ubldit/WIOT/Docs/WIOT_Rev2.jpg

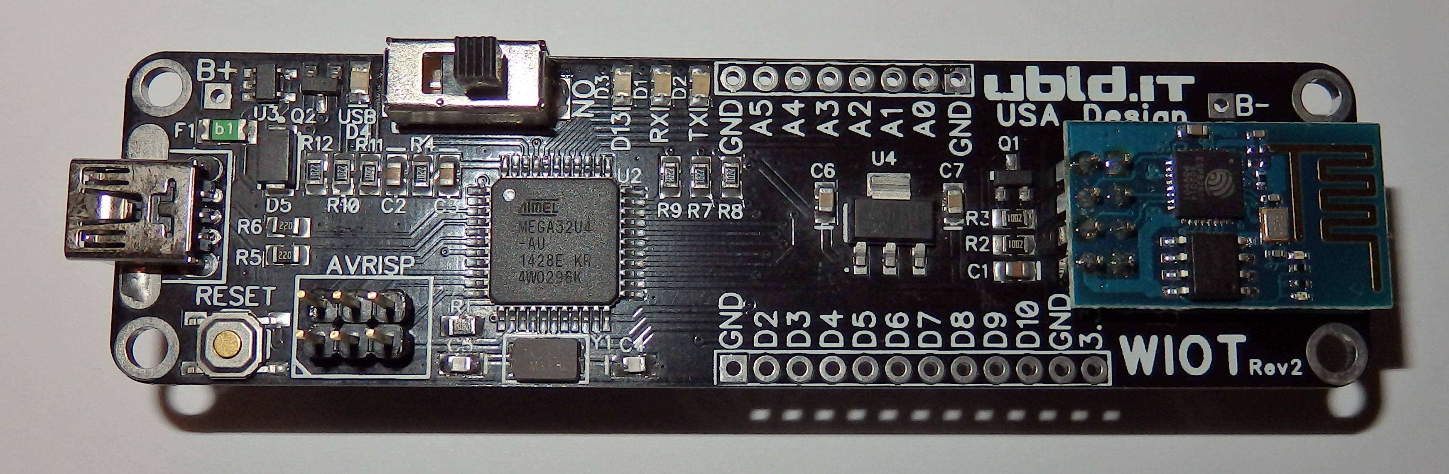
Docs/WIOT_Rev2.jpg
