ubldit/WIOT/README.md

# WIOT: Wireless Internet of Things Arduino-Compatible Board by ubld.it
Arduino Addon, firmware, example sketch, and schematics for the Wireless Internet of Things (WIOT) Arduino-Compatible WiFi (ESP-8266) Board by ubld.it

More information at:
<a href="http://WIOT.org">http://WIOT.org</a> and <a href="https://cockrum.net/electronics.html#WIOT_final">http://cockrum.net/electronics.html#WIOT_final</a>



Directories
-----------
Hardware/ -- Schematic, PCB Layers

Software/ -- Example Arduino sketches

Docs/ -- Documentation and Photos

Device Drivers/ -- Device drivers for WIOT board

License Information
-------------------
The hardware is released under [Creative Commons ShareAlike 4.0 International](https://creativecommons.org/licenses/by-sa/4.0/).

Distributed as-is; no warranty is given.
