ubldit/WIOT/Software/Arduino/README.txt

This directory contains the structure for using the board manager in Arduino 1.6.4
The package_ubld_index.json file must match this (SHA-256 hash and size)
