ubldit/WIOT/Hardware/ubld.it WIOT Rev2 Schematic.pdf

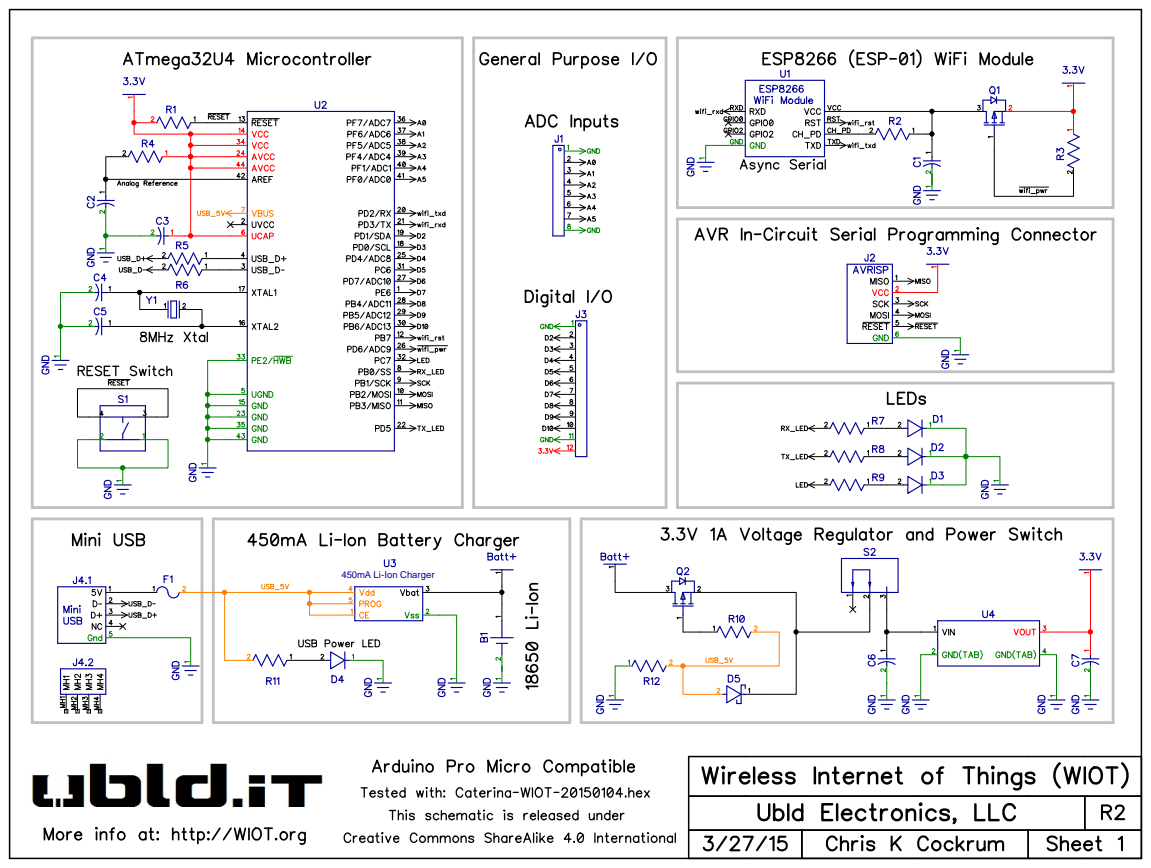
[picture p2: page 1]

450mA Li-Ion Charger
