ubldit/WIOT/Hardware/ubld.it WIOT Rev2 Layout Bottom.pdf

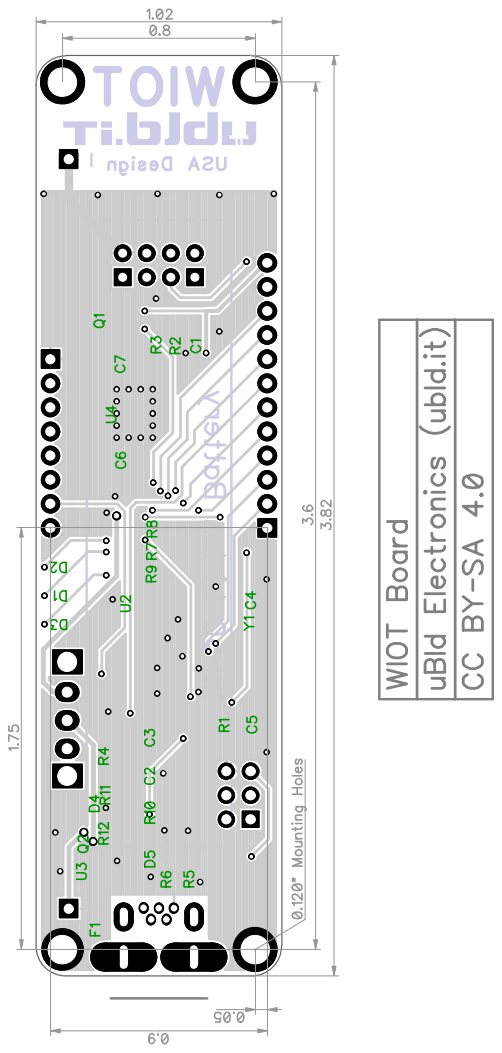
[picture p3: page 1]
