ubldit/WIOT/Hardware/ubld.it WIOT Rev2 Layout Top.pdf

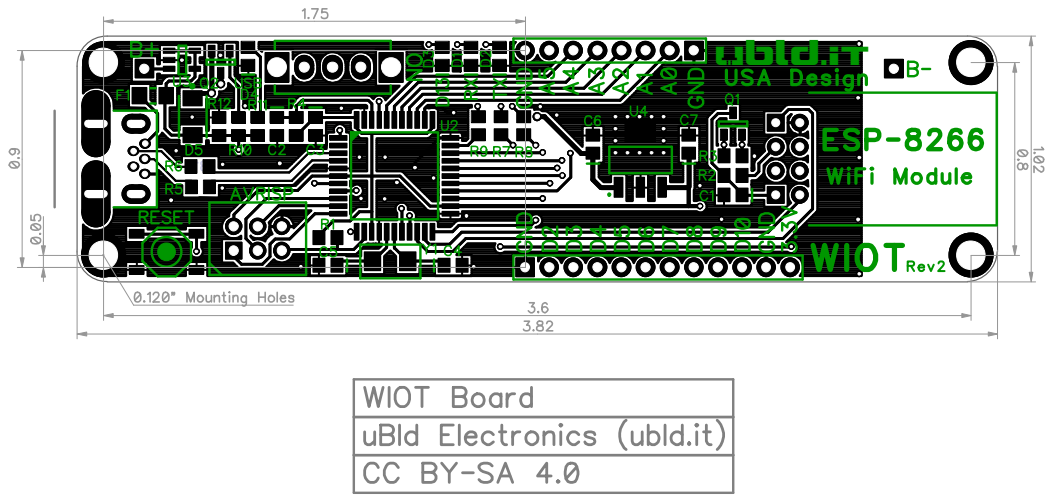
[picture p4: page 1]
