ubldit/WIOT/Software/Arduino 1.6.2 Addon for WIOT/packages/arduino/hardware/avr/1.6.2/bootloaders/caterina-WIOT/build.txt

make clean
make PID=0x0957 F_CPU=8000000
copy Caterina.hex Caterina-WIOT.hex
