ubldit/WIOT/(commit log)

2015-03-27 Initial Checkin of ubld.it WIOT files
    Arduino Compatible Wireless Internet of Things (WIOT) with ESP8266
    (http://WIOT.org)
    by Ubld Electronics, LLC.
    http://ubld.it
2015-03-28 Updated boards.txt and Addon files for Arduino 1.6.1
    Should work with 1.5.8 through 1.6.1
2015-03-28 Updated to turn on ESP-8266 power on Rev 2 hardware
2015-03-28 Forgot pinMode statement for power switching
2015-03-28 Updated Device Drivers
2015-03-28 Updated Device Driver to 1.1 and Sketch
2015-03-28 Updated sketch to reflect latest version of pcb
2015-04-01 Added support files for Arduino 1.6.2
    1.6.2 has a new board manager but it is unclear how to integrate with
    this feature and support forum posts indicate it may be broken. 1.6.2
    moved the arduino hardware files into the user directory.
    [WIOT_WiFi_Demo.ino]
2015-04-01 Re-added the WiFi Demo Sketch
    Re-added after a Github merge conflict issue
    [WIOT_WiFi_Demo.ino]
2015-05-31 Added Arduino 1.6.4 Support
2015-05-31 Updated json for Arduino 1.6.4
2015-05-31 Fixed json for Arduino 1.6.4 IDE
2015-06-05 Added BOM
